borenw/sky130-lns-mac-detector/report/power_area.csv

design | cells | area_um2 | Ctot_pF | energy_per_op_pJ | power_uW_at_50MHz | x_baseline_power | disagreement_pct_vs_baseline
mult baseline | 1476 | 12015.274 | 9.9942 | 9.7144 | 485.7205 | 1.0000 | 0.0000
log K=1 | 416 | 3569.674 | 2.5545 | 2.4830 | 124.1479 | 0.2556 | 5.5996
