borenw/sky130-lns-mac-detector/report/floorplan.csv

design | die_x_um | die_y_um | die_area_um2 | cell_area_um2 | utilization | rows
mult_detector | 135.92 | 136.00 | 18485.0 | 12015.3 | 0.65 | 50
log_detector | 74.78 | 73.44 | 5491.8 | 3569.7 | 0.65 | 27
