borenw/sky130-lns-mac-detector/(list of files, drawings)

Other design files:
veriloga/wave_sst2/tranAn.tran.dsn
