borenw/sky130-lns-mac-detector/verif/sweep_sub_rtl.csv

sid | A | B | C | D | Vth | out_mult | out_log
0 | 25 | 30 | 12 | 40 | 0 | 1 | 1
0 | 25 | 30 | 12 | 40 | 2 | 1 | 1
0 | 25 | 30 | 12 | 40 | 4 | 1 | 1
0 | 25 | 30 | 12 | 40 | 6 | 1 | 1
0 | 25 | 30 | 12 | 40 | 8 | 1 | 1
0 | 25 | 30 | 12 | 40 | 10 | 1 | 1
0 | 25 | 30 | 12 | 40 | 12 | 1 | 1
0 | 25 | 30 | 12 | 40 | 14 | 1 | 1
0 | 25 | 30 | 12 | 40 | 16 | 1 | 1
0 | 25 | 30 | 12 | 40 | 18 | 1 | 1
0 | 25 | 30 | 12 | 40 | 20 | 1 | 1
0 | 25 | 30 | 12 | 40 | 22 | 1 | 1
0 | 25 | 30 | 12 | 40 | 24 | 1 | 1
0 | 25 | 30 | 12 | 40 | 26 | 1 | 1
0 | 25 | 30 | 12 | 40 | 28 | 1 | 1
0 | 25 | 30 | 12 | 40 | 30 | 1 | 1
0 | 25 | 30 | 12 | 40 | 32 | 1 | 1
0 | 25 | 30 | 12 | 40 | 34 | 1 | 1
0 | 25 | 30 | 12 | 40 | 36 | 1 | 1
0 | 25 | 30 | 12 | 40 | 38 | 1 | 1
0 | 25 | 30 | 12 | 40 | 40 | 1 | 1
0 | 25 | 30 | 12 | 40 | 42 | 1 | 1
0 | 25 | 30 | 12 | 40 | 44 | 1 | 1
0 | 25 | 30 | 12 | 40 | 46 | 1 | 1
0 | 25 | 30 | 12 | 40 | 48 | 1 | 1
0 | 25 | 30 | 12 | 40 | 50 | 1 | 1
0 | 25 | 30 | 12 | 40 | 52 | 1 | 1
0 | 25 | 30 | 12 | 40 | 54 | 1 | 1
0 | 25 | 30 | 12 | 40 | 56 | 1 | 1
0 | 25 | 30 | 12 | 40 | 58 | 1 | 1
0 | 25 | 30 | 12 | 40 | 60 | 1 | 1
0 | 25 | 30 | 12 | 40 | 62 | 1 | 1
0 | 25 | 30 | 12 | 40 | 64 | 1 | 1
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
