borenw/sky130-lns-mac-detector/verif/sweep_sub_vec.csv

sid | A | B | C | D | Vth
0 | 25 | 30 | 12 | 40 | 0
0 | 25 | 30 | 12 | 40 | 2
0 | 25 | 30 | 12 | 40 | 4
0 | 25 | 30 | 12 | 40 | 6
0 | 25 | 30 | 12 | 40 | 8
0 | 25 | 30 | 12 | 40 | 10
0 | 25 | 30 | 12 | 40 | 12
0 | 25 | 30 | 12 | 40 | 14
0 | 25 | 30 | 12 | 40 | 16
0 | 25 | 30 | 12 | 40 | 18
0 | 25 | 30 | 12 | 40 | 20
0 | 25 | 30 | 12 | 40 | 22
0 | 25 | 30 | 12 | 40 | 24
0 | 25 | 30 | 12 | 40 | 26
0 | 25 | 30 | 12 | 40 | 28
0 | 25 | 30 | 12 | 40 | 30
0 | 25 | 30 | 12 | 40 | 32
0 | 25 | 30 | 12 | 40 | 34
0 | 25 | 30 | 12 | 40 | 36
0 | 25 | 30 | 12 | 40 | 38
0 | 25 | 30 | 12 | 40 | 40
0 | 25 | 30 | 12 | 40 | 42
0 | 25 | 30 | 12 | 40 | 44
0 | 25 | 30 | 12 | 40 | 46
0 | 25 | 30 | 12 | 40 | 48
0 | 25 | 30 | 12 | 40 | 50
0 | 25 | 30 | 12 | 40 | 52
0 | 25 | 30 | 12 | 40 | 54
0 | 25 | 30 | 12 | 40 | 56
0 | 25 | 30 | 12 | 40 | 58
0 | 25 | 30 | 12 | 40 | 60
0 | 25 | 30 | 12 | 40 | 62
0 | 25 | 30 | 12 | 40 | 64
0 | 25 | 30 | 12 | 40 | 66
0 | 25 | 30 | 12 | 40 | 68
0 | 25 | 30 | 12 | 40 | 70
0 | 25 | 30 | 12 | 40 | 72
0 | 25 | 30 | 12 | 40 | 74
0 | 25 | 30 | 12 | 40 | 76
0 | 25 | 30 | 12 | 40 | 78
0 | 25 | 30 | 12 | 40 | 80
0 | 25 | 30 | 12 | 40 | 82
0 | 25 | 30 | 12 | 40 | 84
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
