borenw/sky130-lns-mac-detector/(commit log)

2026-07-05 Two-design spike detector: exact multiplier vs K=1 log/LNS on sky130
    Full open-source flow: Python golden model (emits the F(d) ROM), parameterized
    Verilog RTL, Icarus verification (both designs bit-exact to their model over
    61,657 vectors), yosys synthesis to sky130 HD, analytic power estimate, and a
    standard-cell floorplan (real GDS + measured die x/y). Log K=1 design: -28% area,
    -27% power at a 4.94% accuracy cost vs exact math. Self-contained GitHub Pages
    comparison page in docs/.
    Claude-Session: https://claude.ai/code/session_01NtS5jDTxUstYfSBuhB1isV
    [floorplan.csv, power_area.csv, vectors.csv]
2026-07-05 Parameterize to 12-bit inputs (was 5-bit); same-scale die comparison
    WIDTH 5->12, VW 11->25 (max S=33,538,050). Golden model switches to Monte-Carlo
    sampling (4M) since the 12-bit space (4096^4 ~ 2.8e14) can't be enumerated; F-ROM
    grows to 47 entries with a byte-wide index and log buses widen to 8 bits. Both
    designs re-verified bit-exact (63,875 vectors, PASS). Multiplier area grows
    quadratically with width while the log datapath grows ~linearly, so the K=1 log
    design now saves -70% area and -74% power (vs -28%/-27% at 5-bit) at a ~5.6%
    accuracy cost. Floorplan views now render both dies at a common scale (Design 2
    nested inside Design 1's footprint frame). Docs/page/README updated.
    Co-Auth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
    [floorplan.csv, power_area.csv, vectors.csv]
2026-07-05 Add datapath block diagram at top of the page
    Inline theme-aware SVG comparing the two datapaths: multiplier baseline (A×B,
    C×D → + → >Vth) vs the log/LNS path (LOD+K=1 log2 → Σ logs → LNS add max+F(d) ROM
    → >log2(Vth)), with a "no × cells" badge. build_page.py also now renders the
    README layout PNGs so they stay in sync.
    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
2026-07-05 Diagram: show the (A·B − C·D) > Vth use case (diagram-only)
    Retarget the block diagram to the actual subtraction use case. Lane ① subtracts
    (signed S). Lane ② shows that LNS avoids true log-domain subtraction by
    rearranging (A·B − C·D) > Vth into A·B > C·D + Vth: Vth's log folds into the LNS
    add with y (indexing the same F ROM via |y−v|), and x = log2(A·B) goes to the
    comparator. Figcaption explains the sign/singular-ROM pitfalls and notes that the
    synthesized netlists and all numbers on the page remain the A·B + C·D build.
    No RTL/model/synthesis changes.
    Claude-Session: https://claude.ai/code/session_01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
2026-07-05 Reframe as general-purpose multiplier elimination; add RTL diagram + worked-example table
    - Drop the "spike detector" framing (title/h1/subtitle/README/SUMMARY) — this is a
    general-purpose demonstration of trading multipliers for a log-domain ROM.
    - Add an RTL-structure block diagram ABOVE the datapath: file-named blocks
    (mult_detector.v; log_detector.v top instantiating lod5.v, lns_add.v, lns_ftable.v),
    arrows labeled with the actual RTL signal names (Ar…Vr, e/f/z, X/Y, s, spike).
    - Add a worked-example table AFTER the datapath: real A,B,C,D,Vth rows through the
    implemented A·B+C·D build (computed by importing the golden model), showing S, the
    K=1 reconstruction Ŝ=2^(s/2),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
2026-07-06 Reframe LUT section in C,D,Vth; name the LUT output Vth′(C,D)
    The "Inside the LUT" section now uses the clean input-factored decomposition
    log₂(C·D + Vth) = log₂(C·D) + Vth′(C,D), naming the 2nd term (the LUT) Vth′(C,D) =
    log₂(1 + 2^(log₂Vth − log₂C·D)) — the log-domain amount Vth lifts log₂(C·D). Formula,
    transfer-plot axes and truth-table headers are all in C, D, Vth (address = the log-gap
    |log₂C·D − log₂Vth|, value = Vth′). The 6-gate realization is kept and honestly noted as
    the design's general bounded correction (in the full detector it combines the two
    products; roles swap when C·D < Vth to keep the address ≥ 0).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
2026-07-06 Add revision badge (top-right): git rev number, short SHA, date
    build_page.py reads git HEAD at build time (rev-list count, short SHA, commit date)
    and renders a pill in the header top-right linking to the commit history. Green dot =
    live. Note: shows the revision the page was built from (one behind after each commit,
    by construction); the history link is always current.
    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
2026-07-06 LUT section: quantized staircase plot, boxed schematic, clarify Vth is programmable
    - Transfer plot now draws the ACTUAL quantized function (quarter-log2 staircases)
    computed from the LUT (max + FTAB), for two programmed Vth (256 / 1024).
    - Enclose the gate schematic in a labeled box: in = log2(C·D), log2(Vth)
    [programmable], out = Vth'.
    - Reword the section: Vth is a runtime input and the LUT is Vth-independent (the
    general correction addressed by the log-gap), so Vth is NOT baked in / locked.
    No RTL change — the implemented design already keeps Vth programmable (comparator).
    Claude-Session: https://claude.ai/c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
2026-07-07 Add Virtuoso schematic + ADE XL testbench for the .va models
    veriloga/virtuoso/: mk_tb.il (SKILL -- builds lns_lib/compare_tb schematic: both VA
    DUTs + A,B,C,D,Vth DC sources + gnd, sets XL to exact=0 kbits=2), compare.ocn (OCEAN
    DC-Vth sweep = scriptable ADE, plots outM/outL + prints flip points), cds.lib, and a
    README with the full GUI recipe (Verilog-A import -> schematic -> ADE XL DC sweep) and
    the expected result (outM flips 1230, outL 1024, band [1024,1228]).
    Note: these are GUI artifacts and were NOT run here -- headless Virtuoso crashes on
    this host (-nograph); the physics is already validated by the direct Spectre run.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
2026-07-07 Add SimVision-native SST2 (.trn/.dsn) database for the waveform comparison
    spectre tb_wave.scs -format sst2 -> wave_sst2/tranAn.tran.{trn,dsn}, SimVision's native
    format (validated readable by simvisdbutil 20.09). Signals: outM outL Vth sM sL x y p1 p2.
    sv_cmd.tcl auto-adds the compare signals to a waveform window.
    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
    [tranAn.tran.dsn]
2026-07-07 Subtraction sweep: drop flat 3,3,3,3 case, add 6 more operand sets (11 total)
    Removed the confusing A·B−C·D=0 panel (always-flat) and added six cases with varied
    cancellation: 20,20,10,10 · 60,60,50,50 (heavy cancellation, wide band) · 100,10,30,30
    · 45,45,15,15 · 12,12,4,4 · 23,19,11,7. Regenerated vectors + re-ran the RTL sim
    (mult_sub/log_sub, 0 mismatches vs model). Updated heading + note; run.sh Phase 4c set
    list updated to match.
    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
    [sweep_sub_rtl.csv, sweep_sub_vec.csv]
2026-07-07 Subtraction sweep: 12 random operand sets, K=2 vs K=4 in separate grids
    Replaced the 11 hand-picked sets with 12 seeded-random draws (positive A·B−C·D, both K
    flips on-panel), and split the accuracy knob into two grids: K=2 (this build) vs K=4
    (double the mantissa bits). Each panel: exact vs log/LNS at that K + disagreement band.
    K=4 tightens most bands; noted it's non-monotone per set (log-quantization collisions —
    e.g. the earlier flat A·B−C·D=100 at K=3, where log2(A·B) and log2(C·D) round equal).
    Curves from the golden model (bit-exact to the RTL, verified at shipped K=2).
    Claude-Session: https://claude.ai/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
